MissouriMRDT/InstrumentsBoard_Hardware/README.md

# InstrumentsBoard_Hardware
Control board for science instruments, including the Raman spectrometer and reflectance spectrometer
