MissouriMRDT/InstrumentsBoard_Hardware/InstrumentsBoard/InstrumentsBoard.step

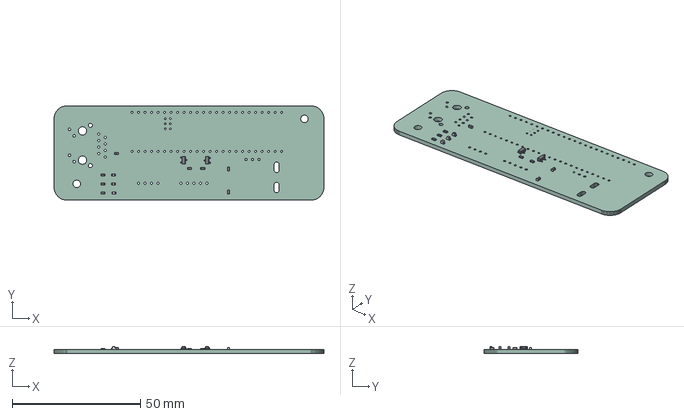
[picture p1: CAD file, 2024-03-04]
InstrumentsBoard/InstrumentsBoard.step
105.4 x 36.8 x 2.85 mm
Raman_Spectrometer_Board PCB
