MissouriMRDT/InstrumentsBoard_Hardware/RamanCCDBoard/RamanCCDBoard.step

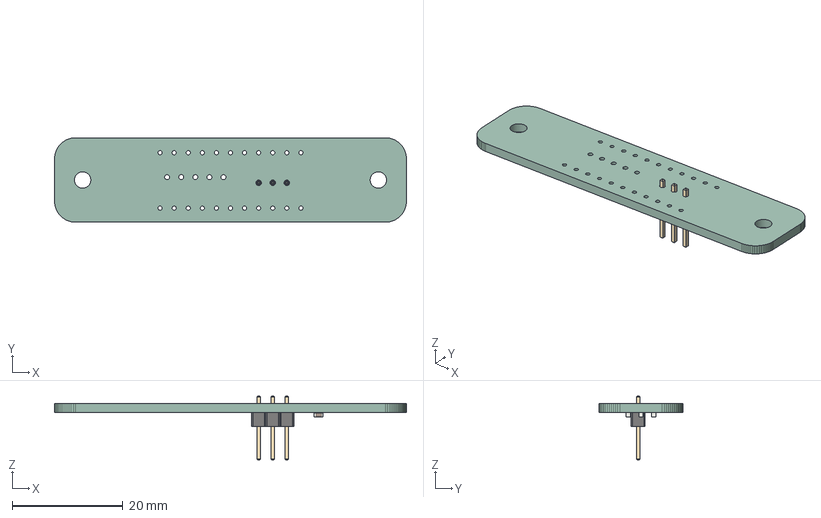
[picture p2: CAD file, 2024-03-04]
RamanCCDBoard/RamanCCDBoard.step
63.5 x 15.2 x 11.5 mm
CCD_Breakout PCB
