MissouriMRDT/InstrumentsBoard_Hardware/RamanCCDBoard/RamanCCDBoard.kicad_pcb

## KiCad design RamanCCDBoard/RamanCCDBoard.kicad_pcb (2024-03-26)

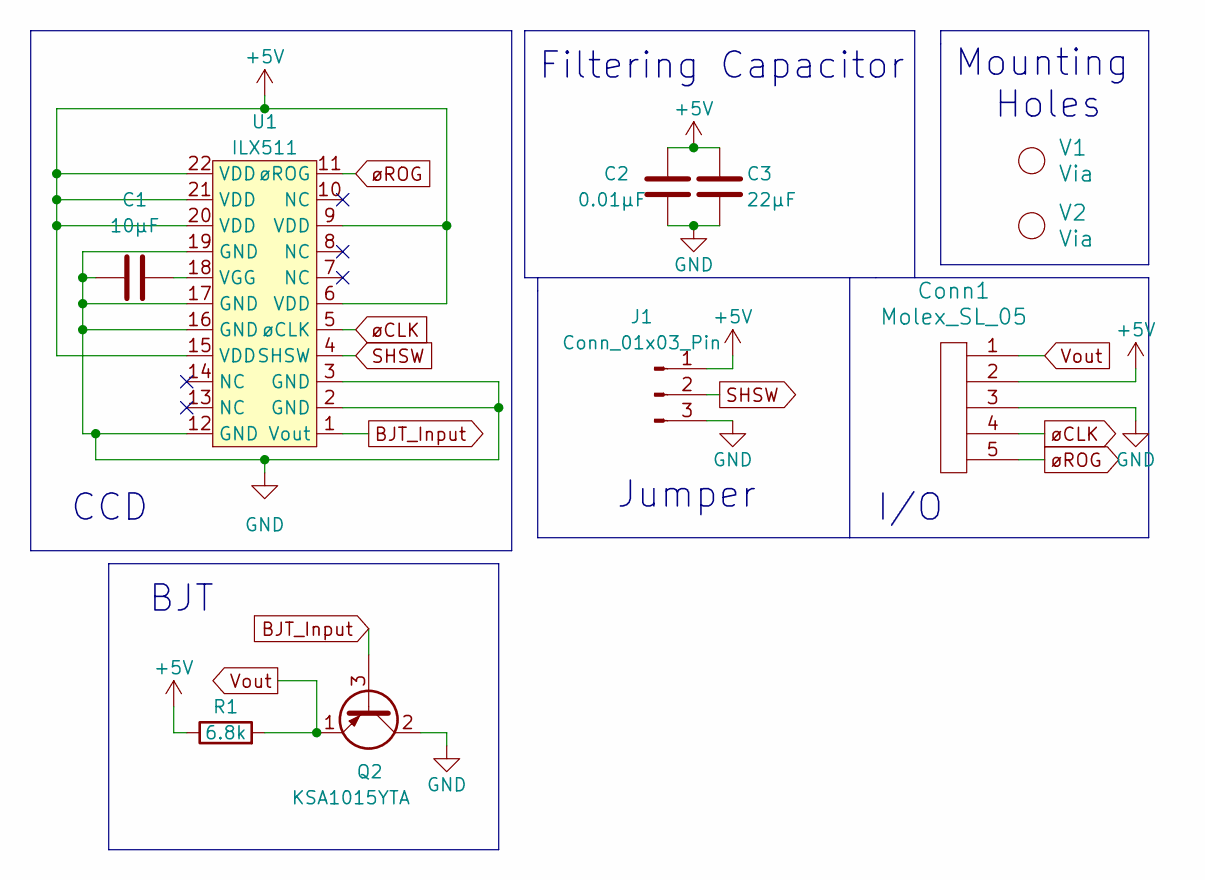
[picture p3: schematic RamanCCDBoard.kicad_sch, Ramen CCD Breakout]

Parts:
C1: 10µF; C_0603_1608Metric_Pad1.08x0.95mm_HandSolder
C2: 0.01µF; C_0603_1608Metric_Pad1.08x0.95mm_HandSolder
C3: 22µF; C_0603_1608Metric_Pad1.08x0.95mm_HandSolder
Conn1: Molex_SL_05; MOLEX_SL_05_Vertical
J1: Conn_01x03_Pin; PinHeader_1x03_P2.54mm_Vertical
Q2: KSA1015YTA; TO-92_Inline
R1: 6.8k; R_0603_1608Metric_Pad0.98x0.95mm_HandSolder
U1: ILX511
V1, V2: Via; 4_40_Hole

Connections:
+5V: C2.2, C3.2, Conn1.2, J1.1, R1.1, U1.6 (VDD), U1.9 (VDD), U1.15 (VDD), U1.20 (VDD), U1.21 (VDD), U1.22 (VDD)
BJT_Input: Q2.3 (B), U1.1 (Vout)
GND: C1.1, C2.1, C3.1, Conn1.3, J1.3, Q2.2 (C), U1.2 (GND), U1.3 (GND), U1.12 (GND), U1.16 (GND), U1.17 (GND), U1.19 (GND)
unnamed: C1.2, U1.18 (VGG)
SHSW: J1.2, U1.4 (SHSW)
Vout: Conn1.1, Q2.1 (E), R1.2
øCLK: Conn1.4, U1.5 (øCLK)
øROG: Conn1.5, U1.11 (øROG)

Notes on the sheet:
Filtering Capacitor
I/O
BJT
CCD
Mounting Holes
Jumper

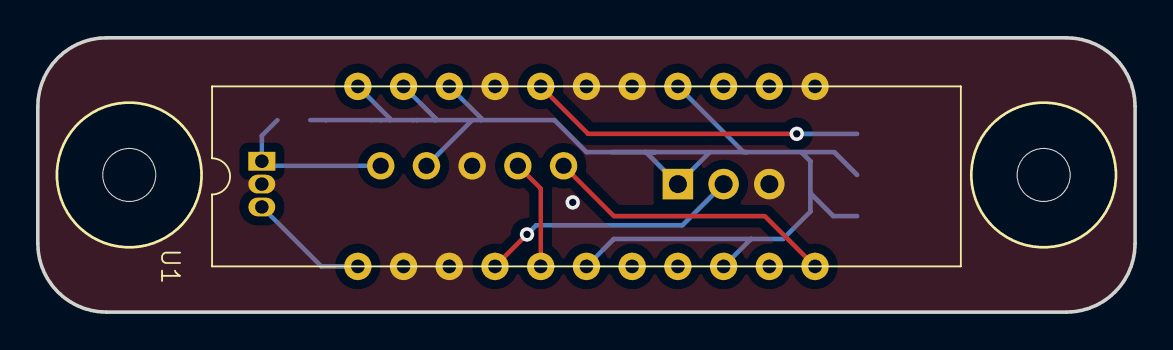
[picture p4: board RamanCCDBoard.kicad_pcb from above]

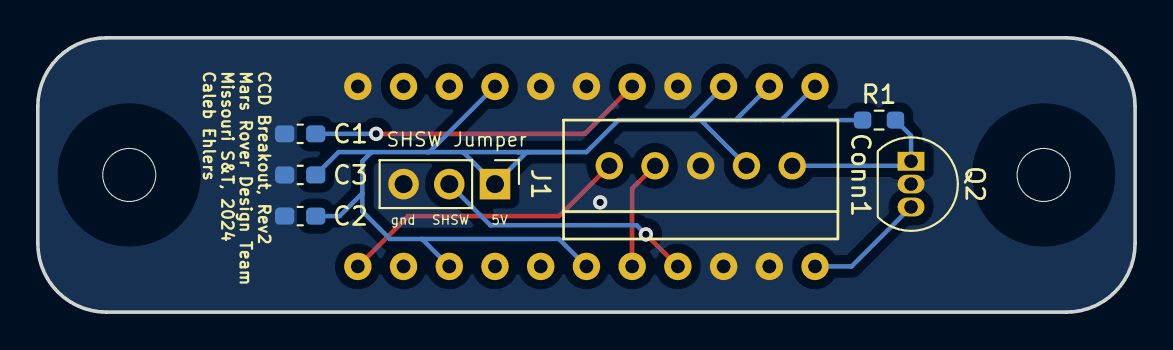
[picture p5: board RamanCCDBoard.kicad_pcb from below]

Board: 2 copper layers, 61.0 x 15.2 mm, 10 parts (7 on the bottom side), 8 nets.
