MissouriMRDT/InstrumentsBoard_Hardware/InstrumentsBoard/InstrumentsBoard.kicad_pcb

## KiCad design InstrumentsBoard/InstrumentsBoard.kicad_pcb (2024-03-26)

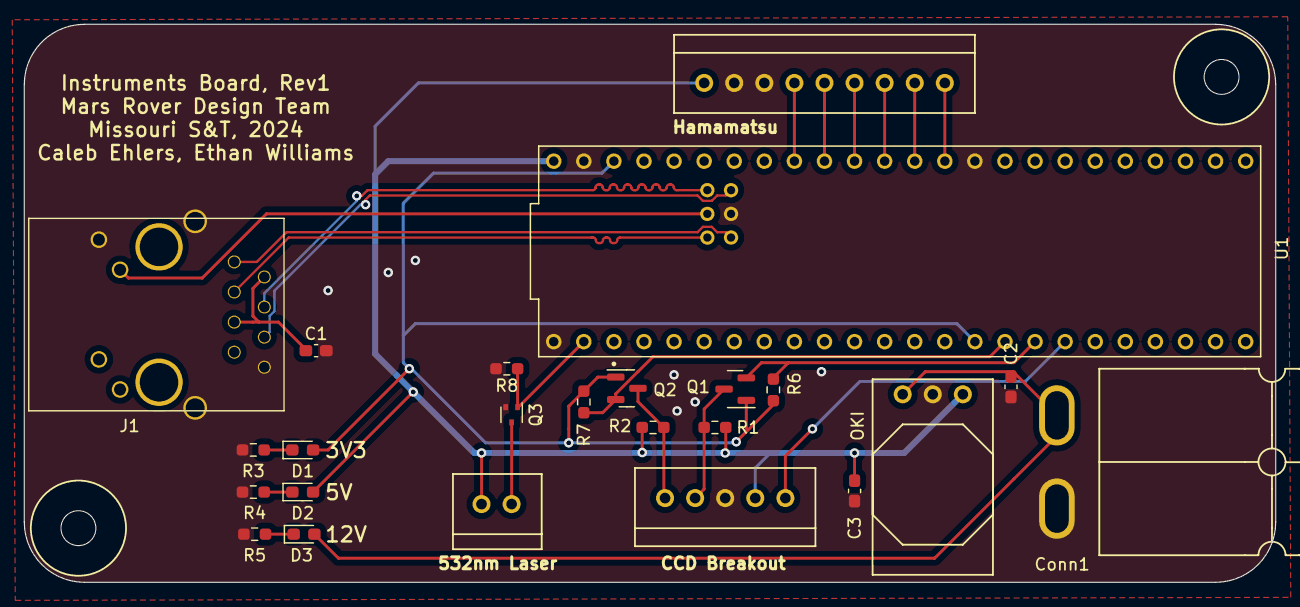
[picture p6: board InstrumentsBoard.kicad_pcb from above]

Board: 2 copper layers, 105.7 x 47.1 mm, 26 parts (0 on the bottom side), 26 nets.

Parts:
C1: 0.1µF; C_0603_1608Metric_Pad1.08x0.95mm_HandSolder
C2, C3: 10µF; C_0603_1608Metric_Pad1.08x0.95mm_HandSolder
Conn1: AndersonPP; Square_Anderson_2_H_Side_By_Side
Conn2: Molex_SL_05; MOLEX_SL_05_Vertical
Conn4: Molex_SL_09; MOLEX_SL_09_Vertical
Conn5: Molex_SL_02; MOLEX_SL_02_Vertical
D1, D2, D3: Green; LED_0603_1608Metric_Pad1.05x0.95mm_HandSolder
J1: RJ45_LED_Shielded; RJ45_Teensy
Q1, Q2: BSS138; SOT-23
Q3: BSS138BK; SOT-523
R1, R2, R6, R7, R8: 4.7k; R_0603_1608Metric_Pad0.98x0.95mm_HandSolder
R3: 100; R_0603_1608Metric_Pad0.98x0.95mm_HandSolder
R4: 300; R_0603_1608Metric_Pad0.98x0.95mm_HandSolder
R5: 1k; R_0603_1608Metric_Pad0.98x0.95mm_HandSolder
U1: Teensy4.1_DEV-16771; Teensy_4_1_Ethernet
U2: OKI; OKI_Horizontal
V1, V2: Via; 4_40_Hole

Connections:
+3V3: D1.2 (A), Q1.1 (G), Q2.1 (G), R6.1, R7.1, U1.3.3V_1 (3.3V), U1.3.3V_2 (3.3V)
+5V: C3.1, Conn2.2, Conn4.1, Conn5.2, D2.2 (A), R1.1, R2.1, U1.VIN, U2.3 (Vo)
+12V: C2.1, Conn1.2 (V+Log), D3.2 (A), U2.1 (Vi)
CCD_CLK_3V3: Q1.2 (S), R6.2, U1.25 (A11)
CCD_CLK_5V: Conn2.4, Q1.3 (D), R1.2
CCD_ROG_3V3: Q2.2 (S), R7.2, U1.24 (A10)
CCD_ROG_5V: Conn2.5, Q2.3 (D), R2.2
CCD_Vout: Conn2.1, U1.26 (A12)
CLK: Conn4.7, U1.15 (A1)
EOS: Conn4.4, U1.18 (A4)
GND: C1.2, C2.2, C3.2, Conn1.1 (GND), Conn2.3, Conn4.2, Conn4.3, J1.8, J1.9, J1.SH, Q3.2 (S), R3.2, R4.2, R5.2, R8.2, U1.GND1 (GND), U1.GND2 (GND), U1.GND3 (GND), U1.GND5 (GND), U2.2 (GND)
Green_Laser_3V3: Q3.1 (G), R8.1, U1.0 (RX1)
LED: J1.10, U1.LED
unnamed: C1.1, J1.2, J1.5
unnamed: D1.1 (K), R3.1
unnamed: D2.1 (K), R4.1
unnamed: D3.1 (K), R5.1
unnamed: Conn5.1, Q3.3 (D)
R+: J1.4, U1.R+
R-: J1.6, U1.R-
START: Conn4.6, U1.16 (A2)
T+: J1.1, U1.T+
T-: J1.3, U1.T-
TRG: Conn4.5, U1.17 (A3)
VIDEO: Conn4.8, U1.14 (A0)
WHITE_LED: Conn4.9, U1.13 (SCK)
