MissouriMRDT/InstrumentsBoard_Hardware/(commit log)

2024-03-04 commit Raman boards
    [InstrumentsBoard-B_Cu.gbr, InstrumentsBoard-B_Mask.gbr, InstrumentsBoard-B_Paste.gbr, InstrumentsBoard-B_Silkscreen.gbr, InstrumentsBoard-Edge_Cuts.gbr, InstrumentsBoard-F_Cu.gbr, InstrumentsBoard-F_Mask.gbr, InstrumentsBoard-F_Paste.gbr]
2024-03-04 laser diode board changes
    [RamanDiodeBoard.kicad_pcb, RamanDiodeBoard.kicad_sch]
2024-03-05 add bjt to ccd
    [RamanCCDBoard.kicad_pcb, RamanCCDBoard.kicad_sch]
2024-03-05 change pin ordering for ccd molex
    [InstrumentsBoard.kicad_pcb, InstrumentsBoard.kicad_sch, RamanCCDBoard.kicad_pcb, RamanCCDBoard.kicad_sch]
2024-03-05 misc cleanup
    [InstrumentsBoard.kicad_pcb, RamanCCDBoard.kicad_pcb, RamanDiodeBoard.kicad_pcb]
2024-03-06 Added Hamamatsu Connector, Updated Silkscreen
    [InstrumentsBoard.kicad_pcb, InstrumentsBoard.kicad_sch]
2024-03-07 Labeled All Pins, Shifted Teensy Over
    [InstrumentsBoard.kicad_pcb, InstrumentsBoard.kicad_sch]
2024-03-07 fix 5V traces
    [RamanCCDBoard.kicad_pcb]
2024-03-07 remove laser diode board, add laser mosfet
    [InstrumentsBoard.kicad_pcb, InstrumentsBoard.kicad_sch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]
2024-03-07 Fixed Hamamatsu Silkscreen
    [InstrumentsBoard.kicad_pcb]
2024-03-11 revert back to laser diode board
    [InstrumentsBoard.kicad_pcb, InstrumentsBoard.kicad_sch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]
2024-03-12 Revert "revert back to laser diode board"
    This reverts commit 6528700a9c51bf2c3bc149a74fbf2f6639f4022b.
    [InstrumentsBoard.kicad_pcb, InstrumentsBoard.kicad_sch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]
2024-03-13 board review changes
    [InstrumentsBoard.kicad_pcb, InstrumentsBoard.kicad_sch, RamanCCDBoard.kicad_pcb]
2024-03-13 fix low side toggle circuit
    [InstrumentsBoard.kicad_pcb, InstrumentsBoard.kicad_sch]
2024-03-17 update laser mosfet package
    [InstrumentsBoard.kicad_pcb, InstrumentsBoard.kicad_sch]
2024-03-20 Bold Pin Labels
    [InstrumentsBoard.kicad_pcb]
2024-03-26 generated gerbs
    [InstrumentsBoard-B_Cu.gbr, InstrumentsBoard-B_Mask.gbr, InstrumentsBoard-B_Paste.gbr, InstrumentsBoard-B_Silkscreen.gbr, InstrumentsBoard-Edge_Cuts.gbr, InstrumentsBoard-F_Cu.gbr, InstrumentsBoard-F_Mask.gbr, InstrumentsBoard-F_Paste.gbr]
